Noah-Bakr/Hospital-Medicine-Delivery-Robot/Resources/Circuit Diagram.png

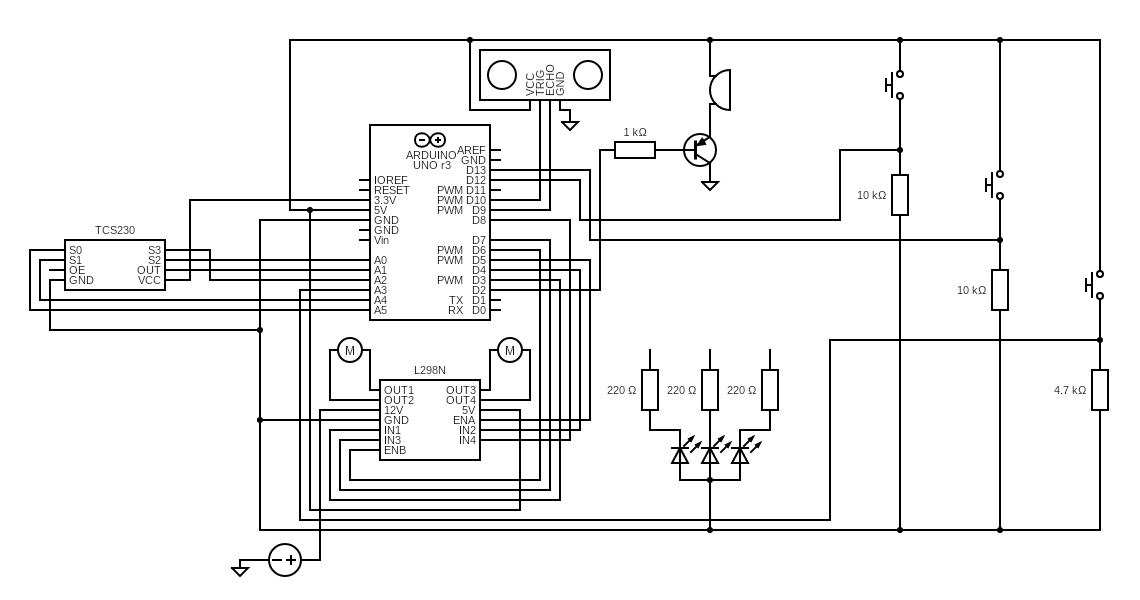
Resources/Circuit Diagram.png
