Noah-Bakr/Hospital-Medicine-Delivery-Robot/Resources/System Diagram.png

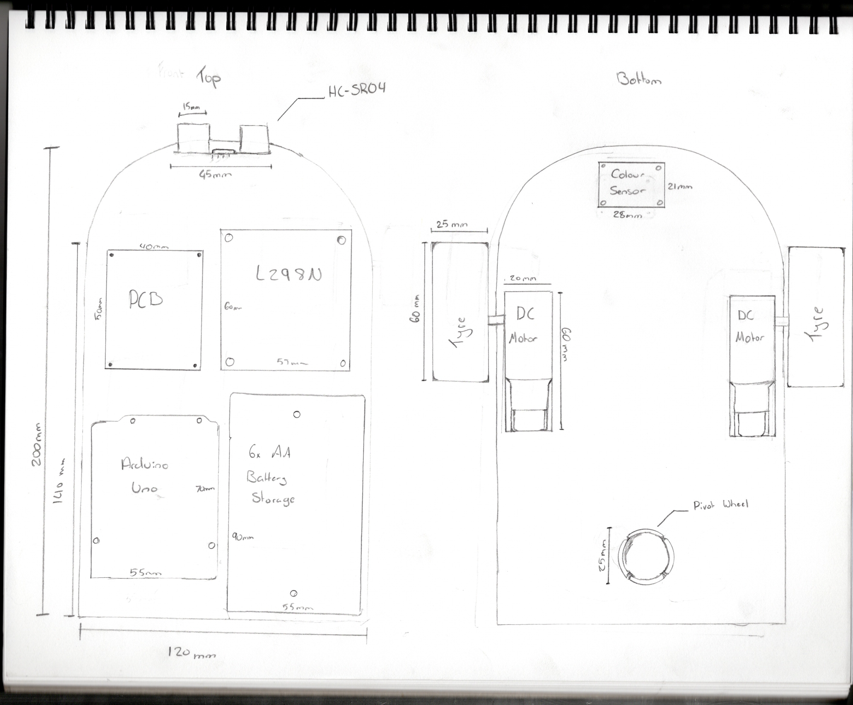
Resources/System Diagram.png
