Noah-Bakr/Hospital-Medicine-Delivery-Robot/(commit log)

2025-06-20 Arduino Code
2025-06-20 Circuit and System Diagram
